AdvancerTechnologies/MuscleMouse/Pictures/20130727_114115.jpg

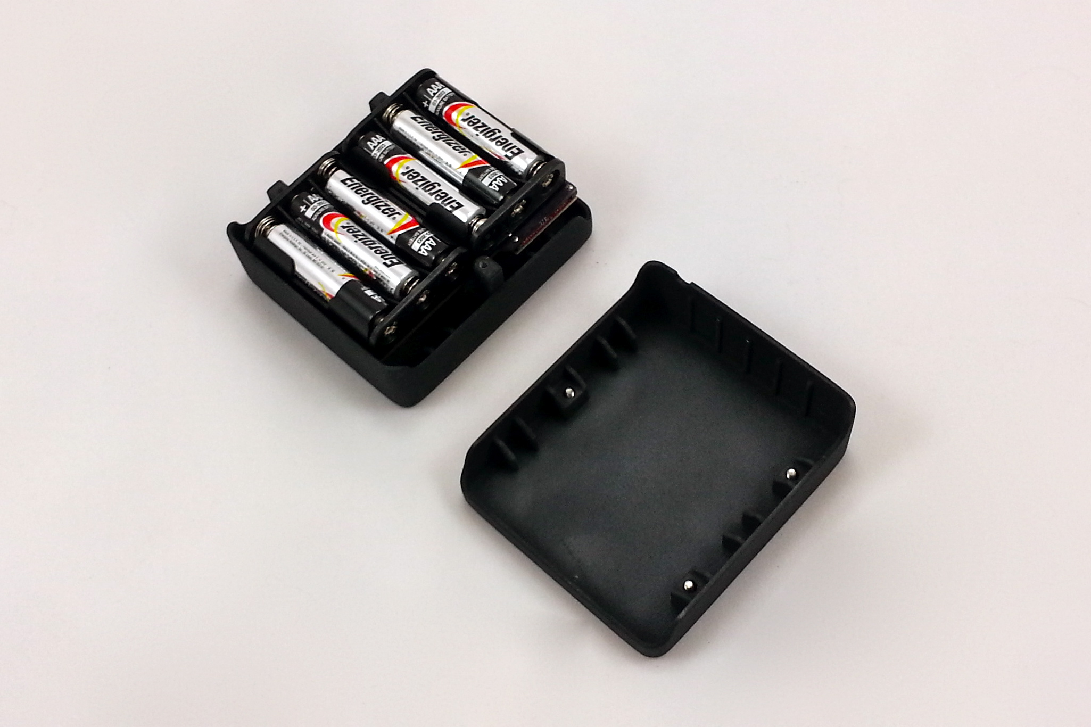
Pictures/20130727_114115.jpg
