AdvancerTechnologies/MuscleMouse/Pictures/20130727_113548.jpg

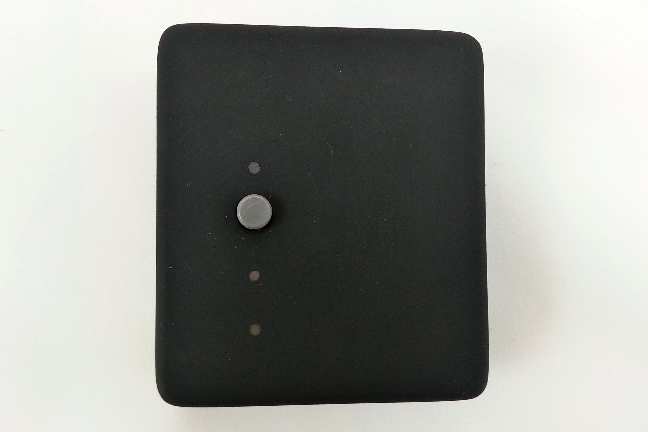
Pictures/20130727_113548.jpg
