AdvancerTechnologies/MuscleMouse/README.md

Muscle-Mouse
============

Example code and files for the Muscle Mouse project
