AdvancerTechnologies/MuscleMouse/Pictures/20130727_113004.jpg

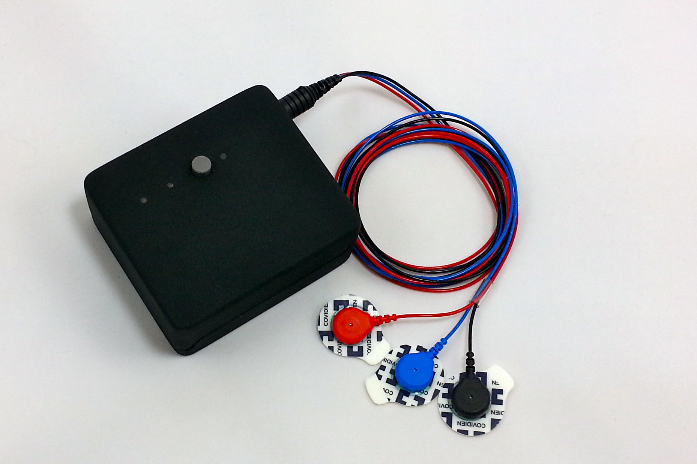
Pictures/20130727_113004.jpg
