AdvancerTechnologies/MuscleMouse/Pictures/20130727_113408.jpg

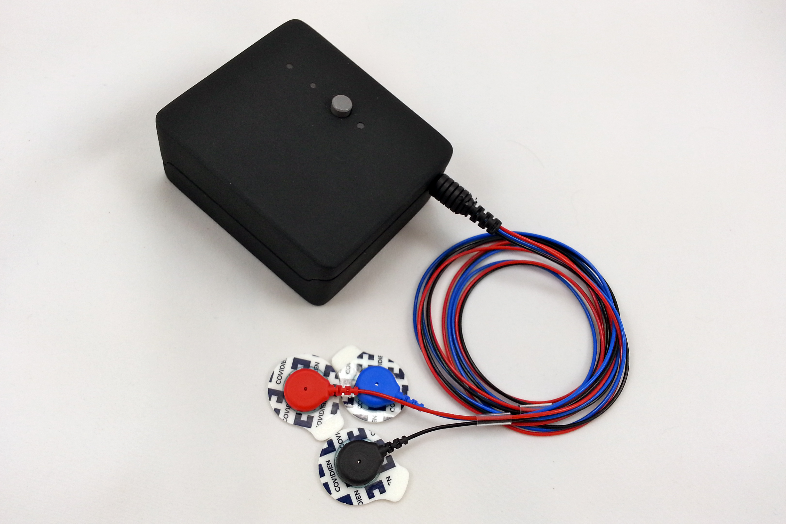
Pictures/20130727_113408.jpg
