AdvancerTechnologies/MuscleMouse/Pictures/20130727_113649.jpg

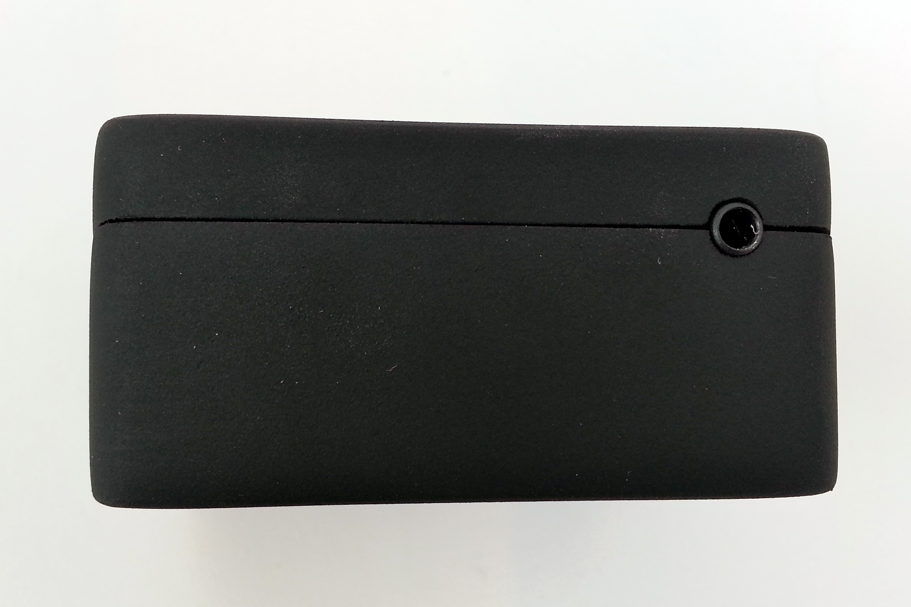
Pictures/20130727_113649.jpg
