AdvancerTechnologies/MuscleMouse/Pictures/20130727_113705.jpg

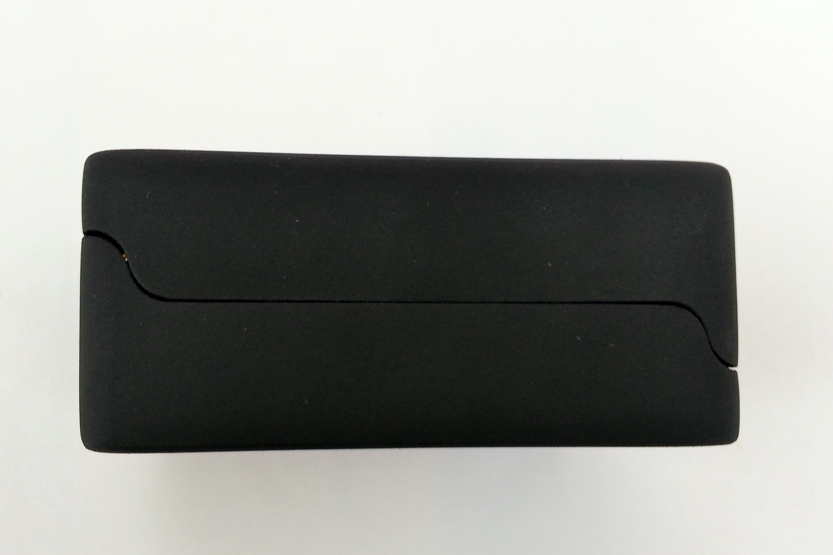
Pictures/20130727_113705.jpg
