AdvancerTechnologies/MuscleMouse/Pictures/20130727_114227.jpg

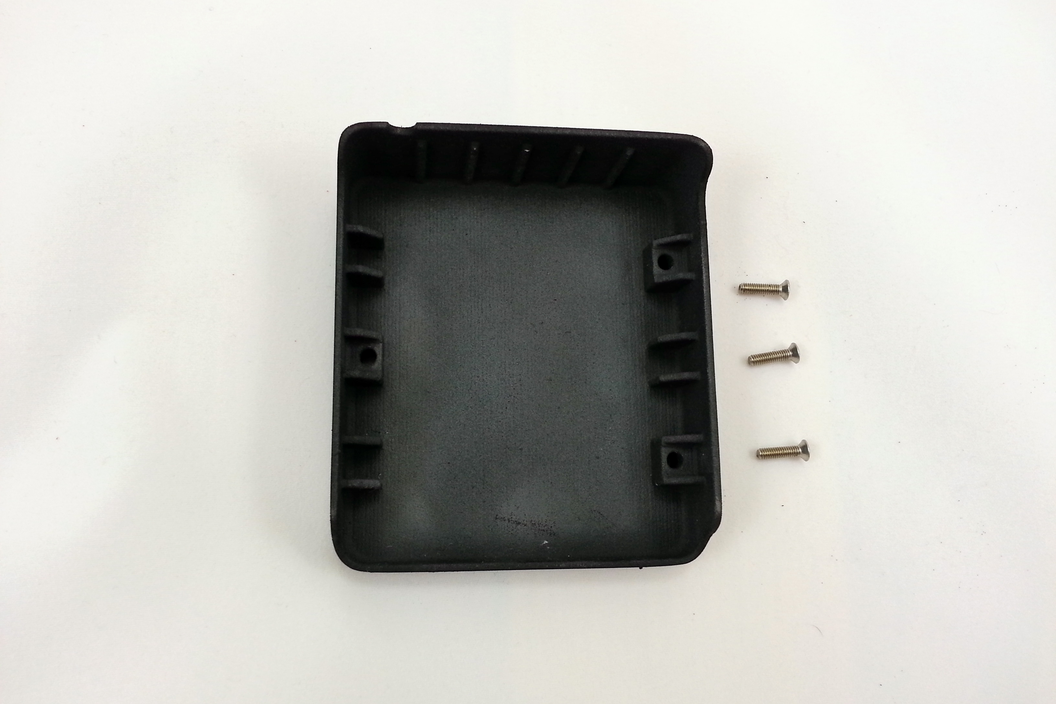
Pictures/20130727_114227.jpg
