AdvancerTechnologies/MuscleMouse/Pictures/20130727_114305.jpg

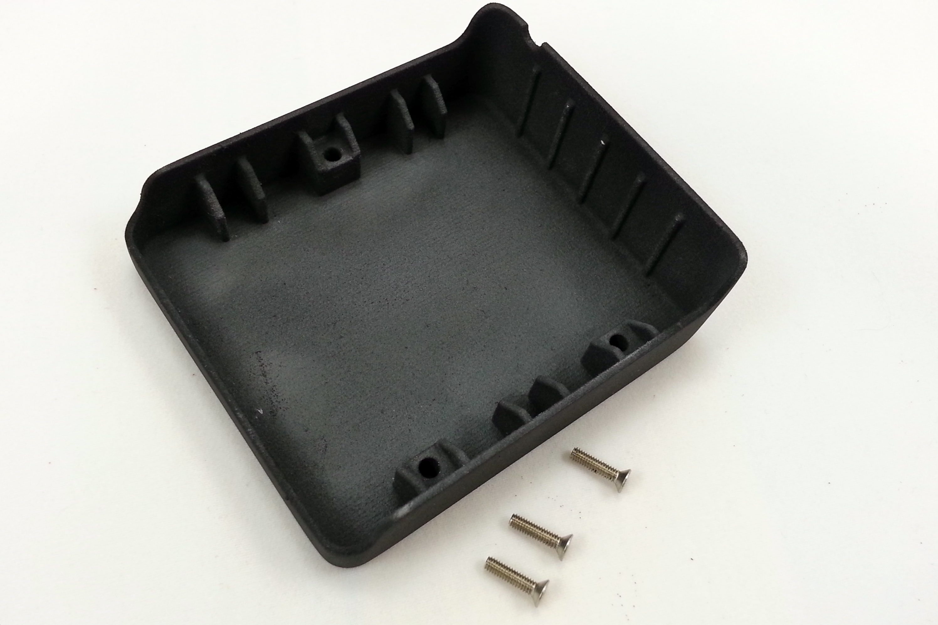
Pictures/20130727_114305.jpg
