AdvancerTechnologies/MuscleMouse/Pictures/20130727_114322.jpg

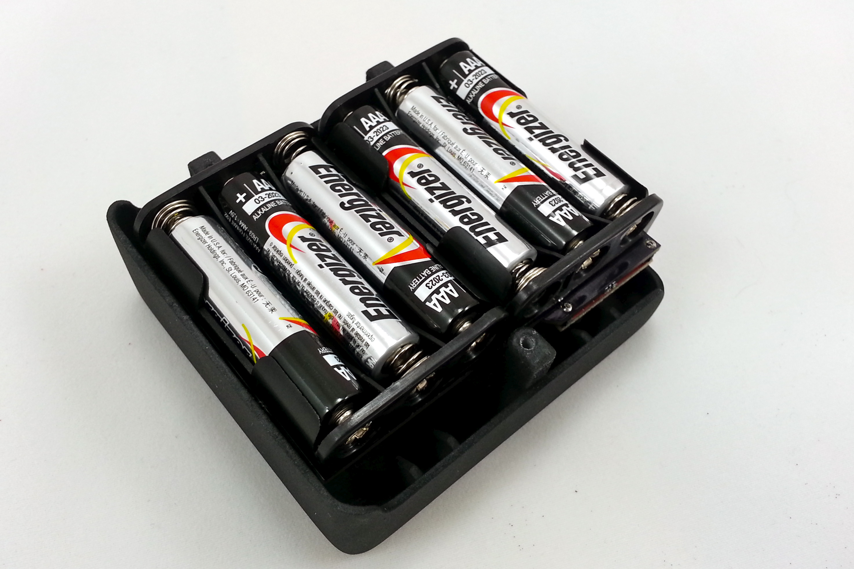
Pictures/20130727_114322.jpg
