AdvancerTechnologies/MuscleMouse/Pictures/20130727_114401.jpg

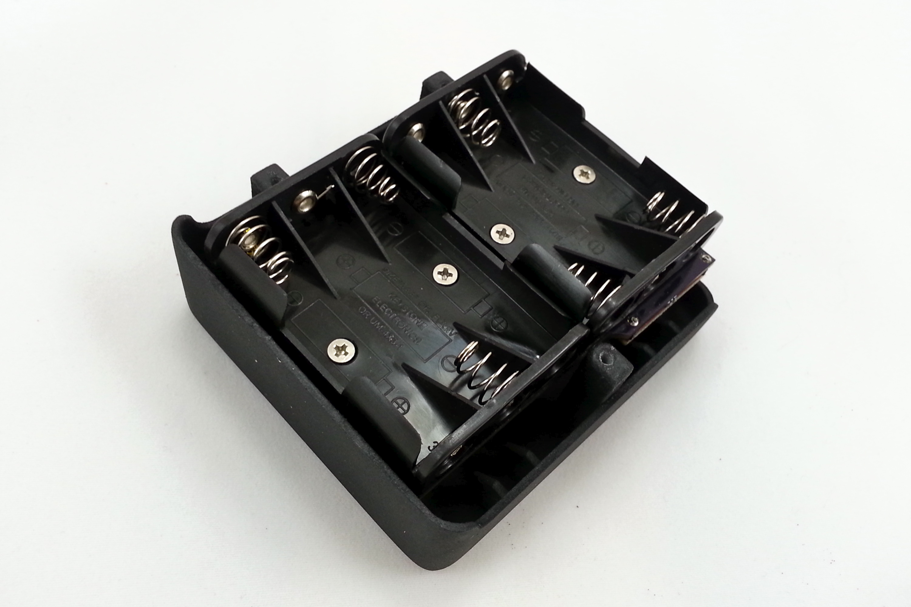
Pictures/20130727_114401.jpg
