AdvancerTechnologies/MuscleMouse/Pictures/20130727_114428.jpg

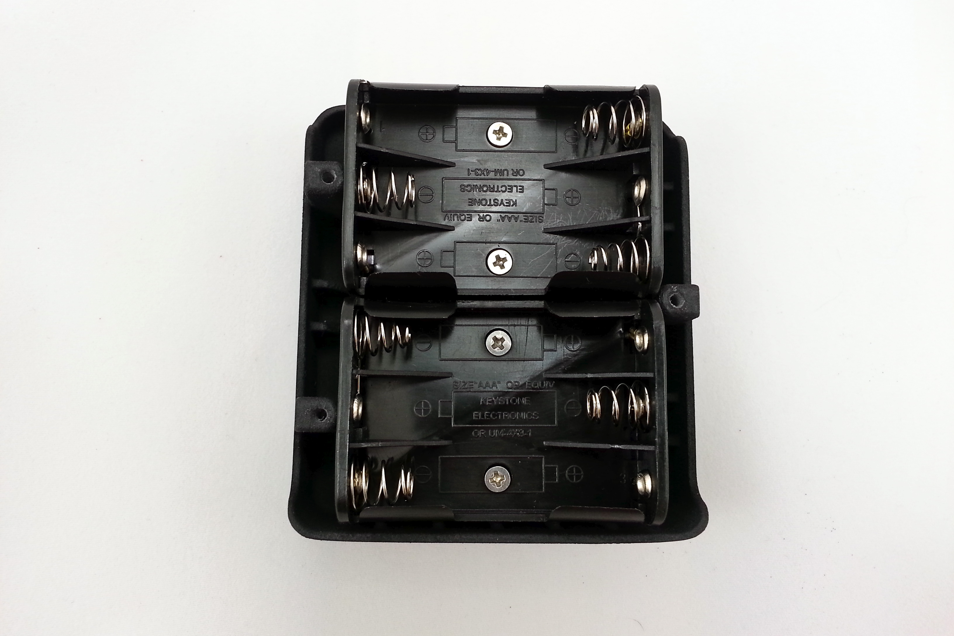
Pictures/20130727_114428.jpg
