AdvancerTechnologies/MuscleMouse/Pictures/20130727_114931.jpg

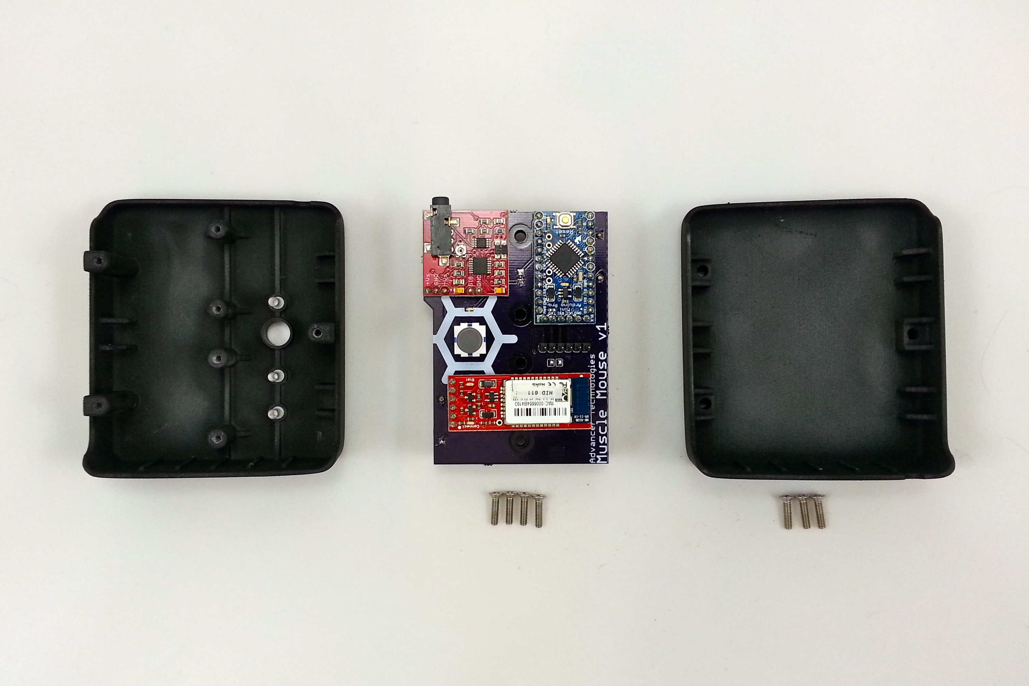
Pictures/20130727_114931.jpg
