AdvancerTechnologies/MuscleMouse/Pictures/20130727_115040.jpg

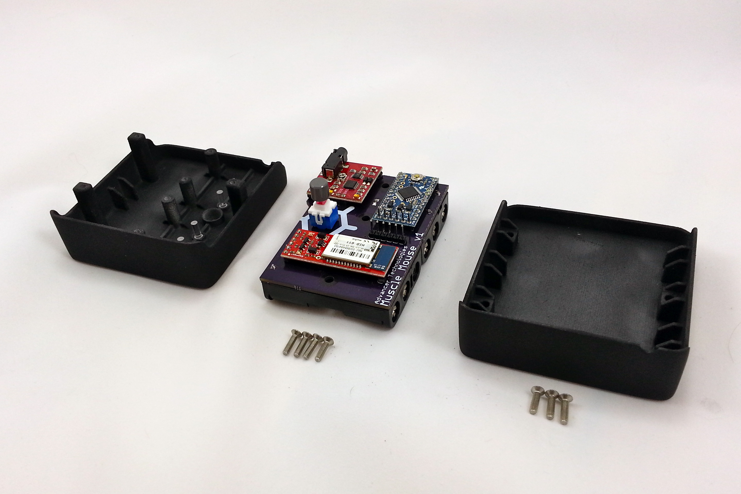
Pictures/20130727_115040.jpg
