AdvancerTechnologies/MuscleMouse/Pictures/20130727_115242.jpg

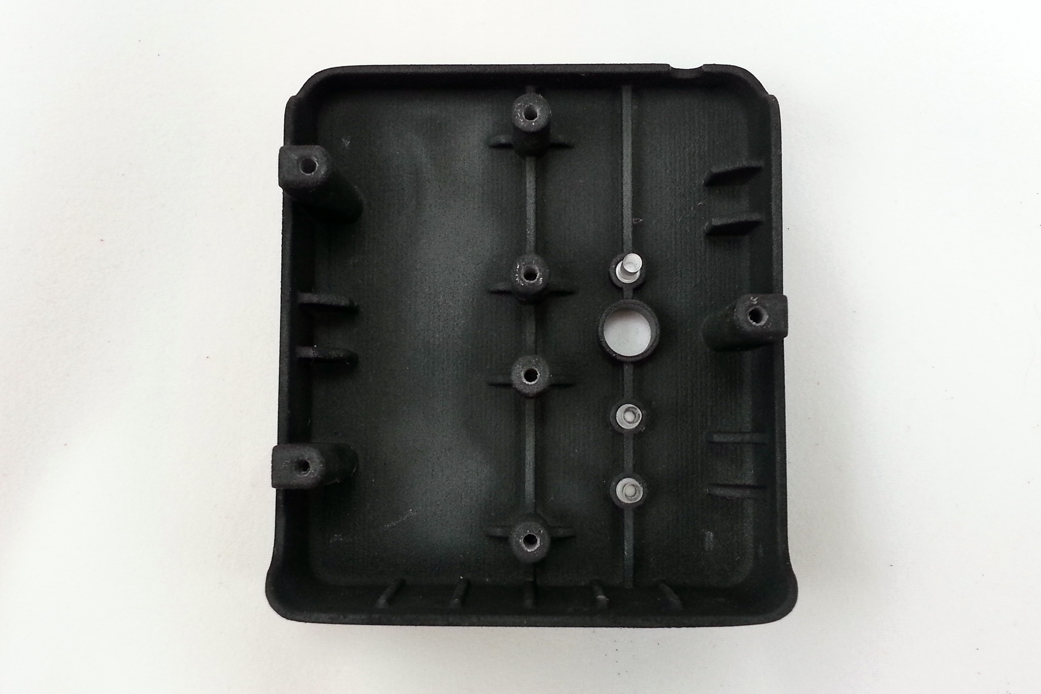
Pictures/20130727_115242.jpg
