AdvancerTechnologies/MuscleMouse/Pictures/20130727_115309.jpg

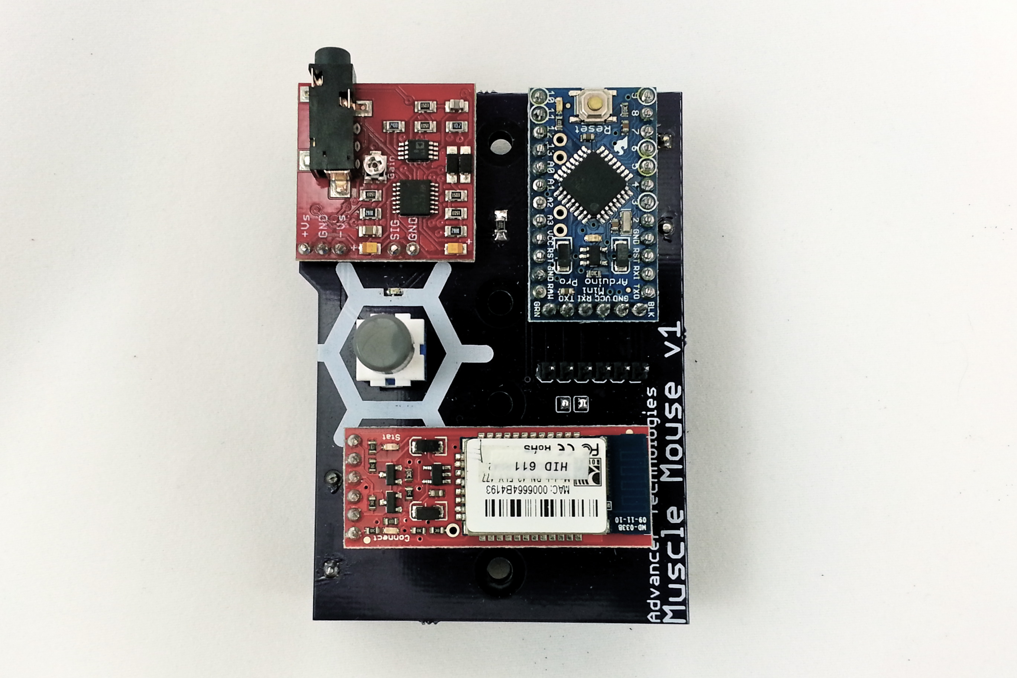
Pictures/20130727_115309.jpg
