AdvancerTechnologies/MuscleMouse/Pictures/20130727_115348.jpg

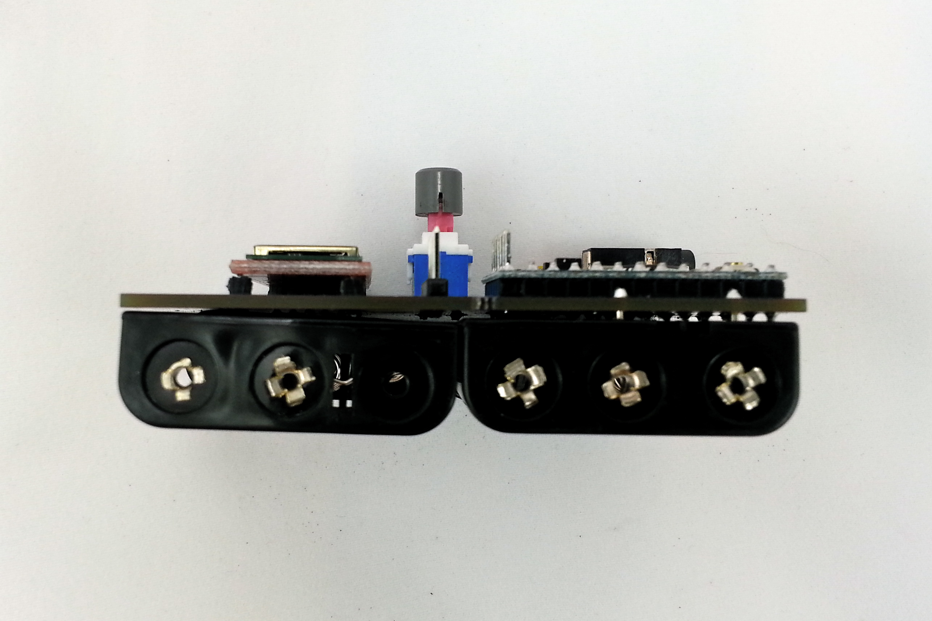
Pictures/20130727_115348.jpg
