AdvancerTechnologies/MuscleMouse/Pictures/20130727_115431.jpg

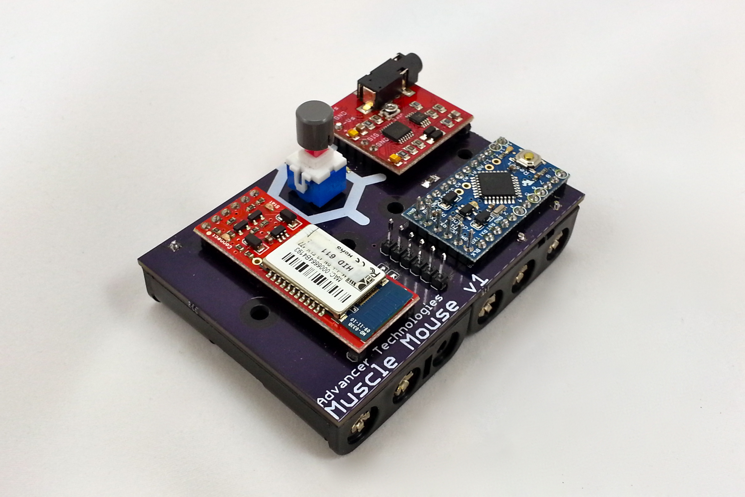
Pictures/20130727_115431.jpg
