AdvancerTechnologies/MuscleMouse/Pictures/20130727_115443.jpg

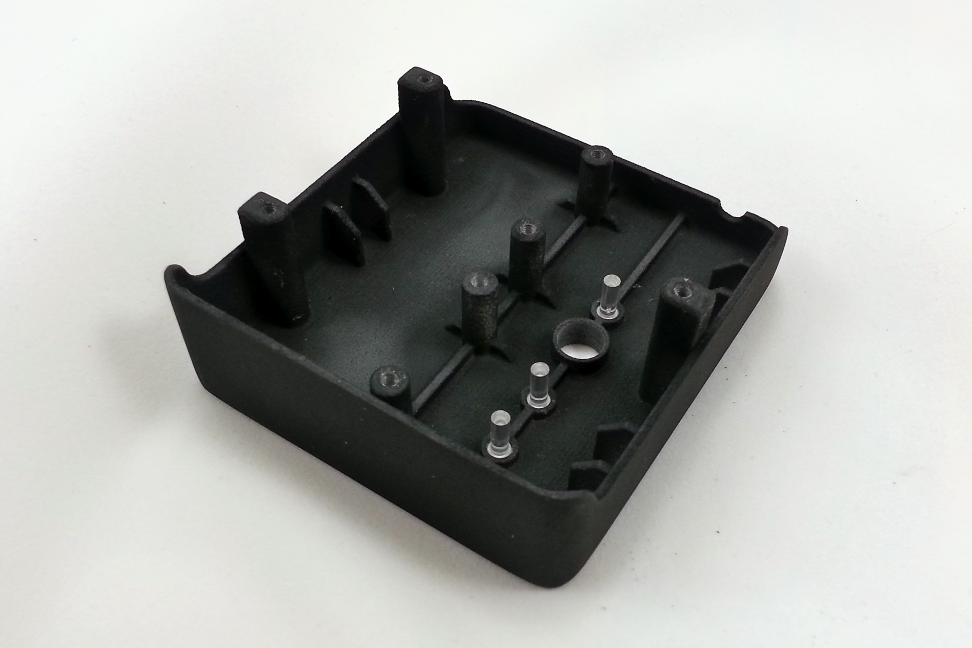
Pictures/20130727_115443.jpg
