AdvancerTechnologies/MuscleMouse/Pictures/20130727_115458.jpg

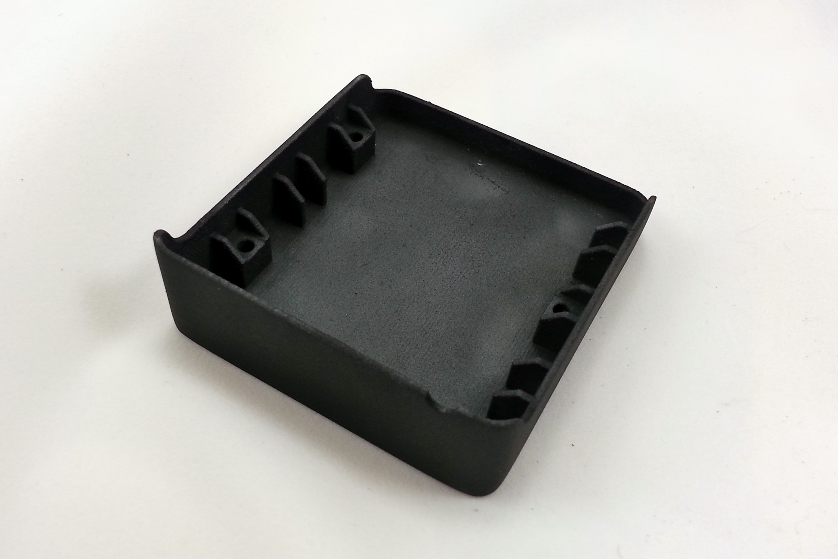
Pictures/20130727_115458.jpg
