AdvancerTechnologies/MuscleMouse/Pictures/20130727_184438_70142.jpg

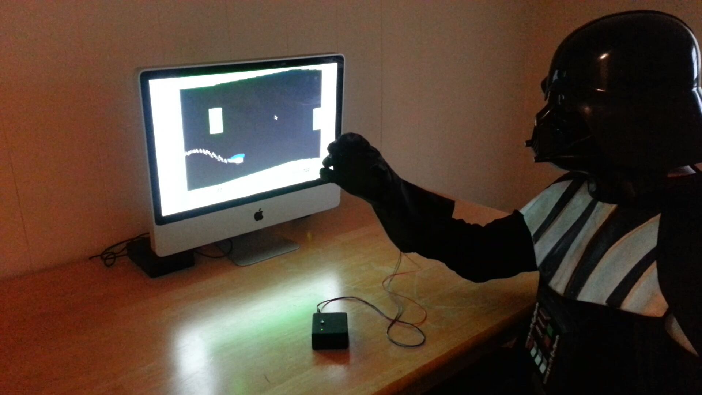
Pictures/20130727_184438_70142.jpg
