AdvancerTechnologies/MuscleMouse/Pictures/20130728_143617_17169.jpg

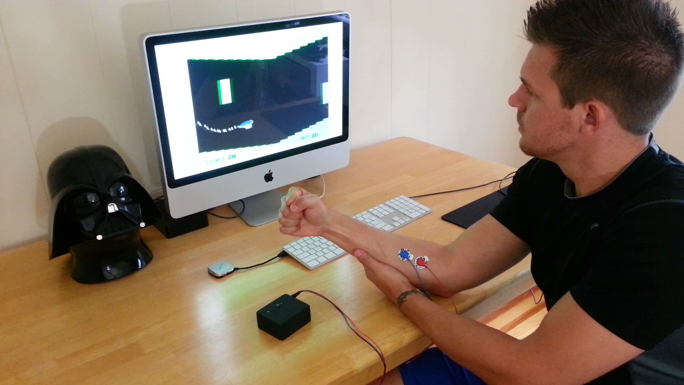
Pictures/20130728_143617_17169.jpg
