AdvancerTechnologies/MuscleMouse/Pictures/20130730_215102.jpg

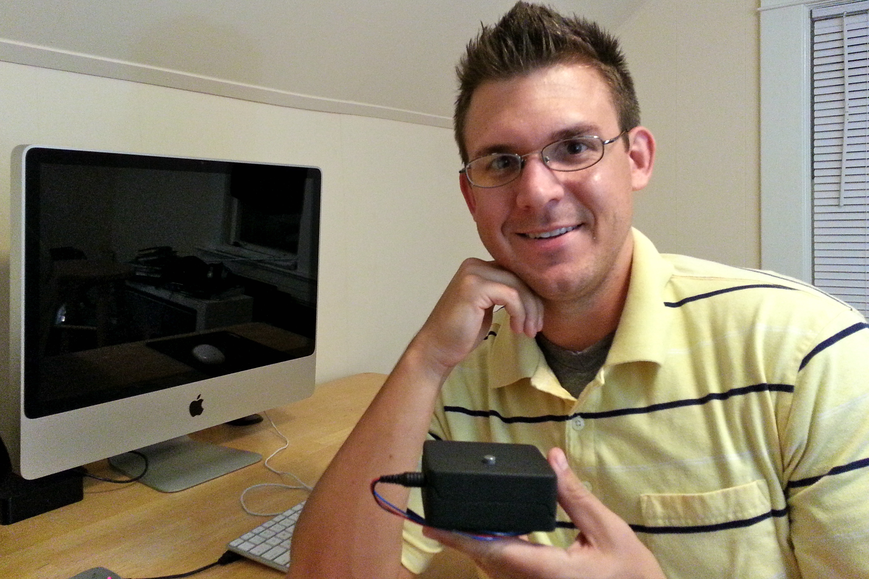
Pictures/20130730_215102.jpg
