AdvancerTechnologies/MuscleMouse/Pictures/Animated Picture 1.gif

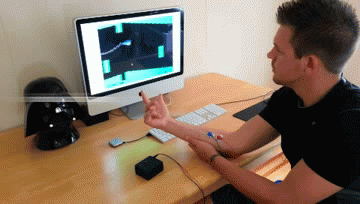
Pictures/Animated Picture 1.gif
