AdvancerTechnologies/MuscleMouse/Pictures/Animated Picture 2.gif

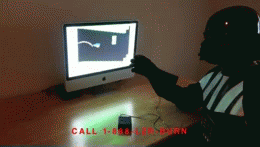
Pictures/Animated Picture 2.gif
