AdvancerTechnologies/MuscleMouse/CAD/Muscle Mouse v1_1.SLDASM

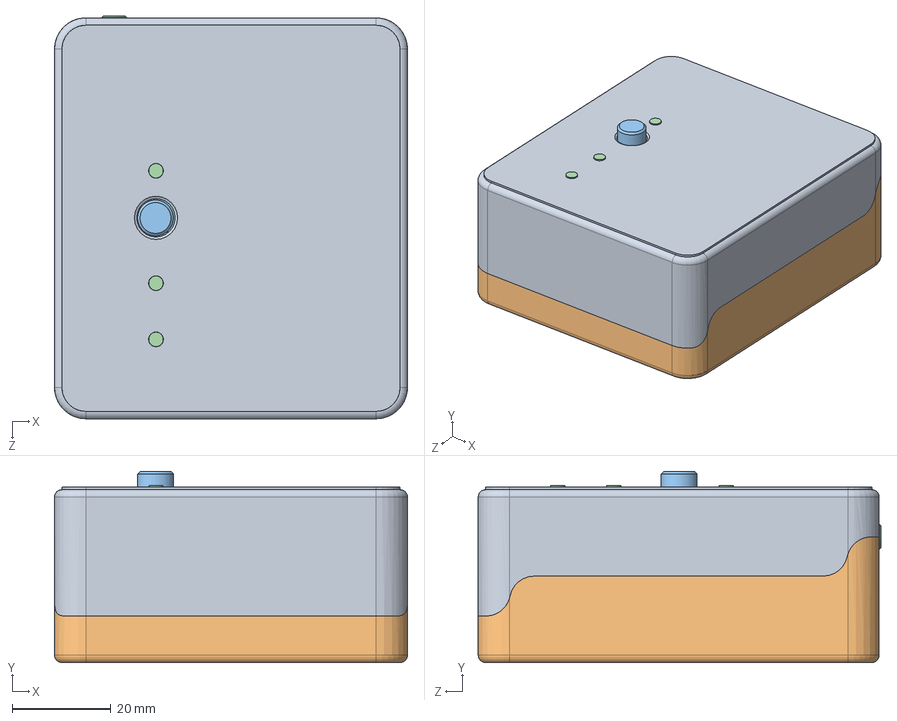
[picture p37: CAD file, 2014-12-28]
CAD/Muscle Mouse v1_1.SLDASM
71.4 x 38.7 x 81.5 mm
EnclosureTop
EnclosureBottom
ButtonCap
11mmLightTube x 3
