AdvancerTechnologies/MuscleMouse/CAD/ClippedPin.SLDPRT

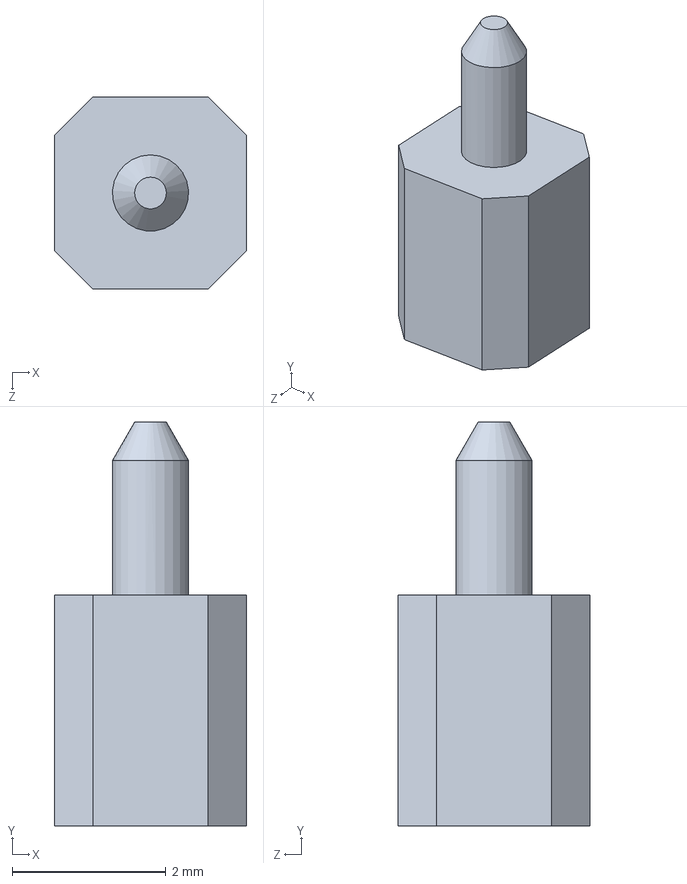
[picture p38: CAD file, 2014-12-28]
CAD/ClippedPin.SLDPRT
2.50 x 5.25 x 2.50 mm
