AdvancerTechnologies/MuscleMouse/CAD/ArduinoMiniPro.SLDPRT

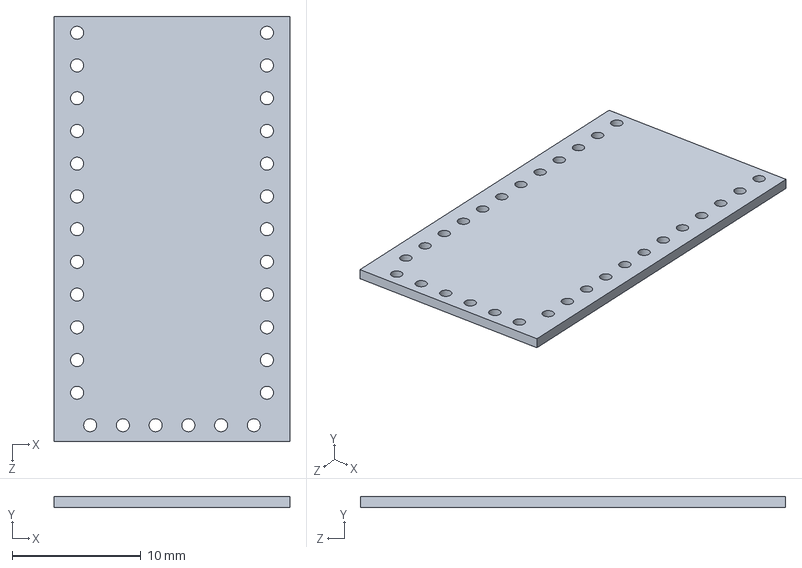
[picture p39: CAD file, 2014-12-28]
CAD/ArduinoMiniPro.SLDPRT
18.3 x 0.85 x 33.0 mm
