AdvancerTechnologies/MuscleMouse/CAD/EnclosureBottom.SLDPRT

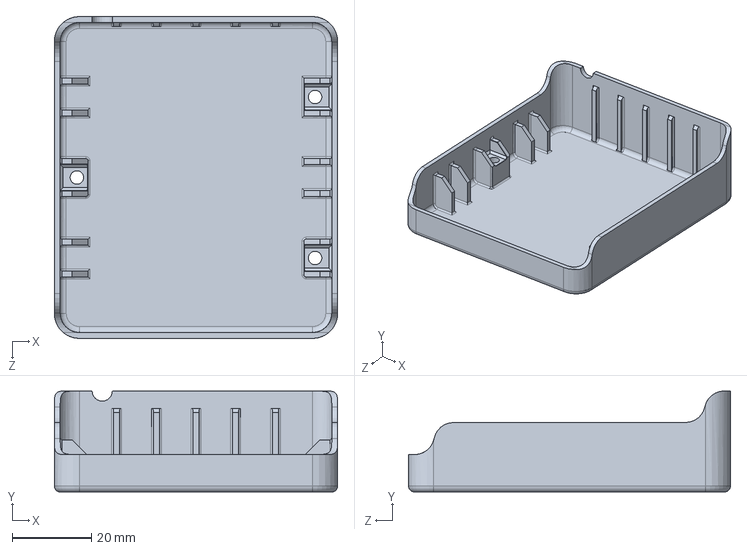
[picture p40: CAD file, 2014-12-28]
CAD/EnclosureBottom.SLDPRT
71.4 x 25.4 x 81.2 mm
