AdvancerTechnologies/MuscleMouse/CAD/keystone-PN2479.SLDPRT

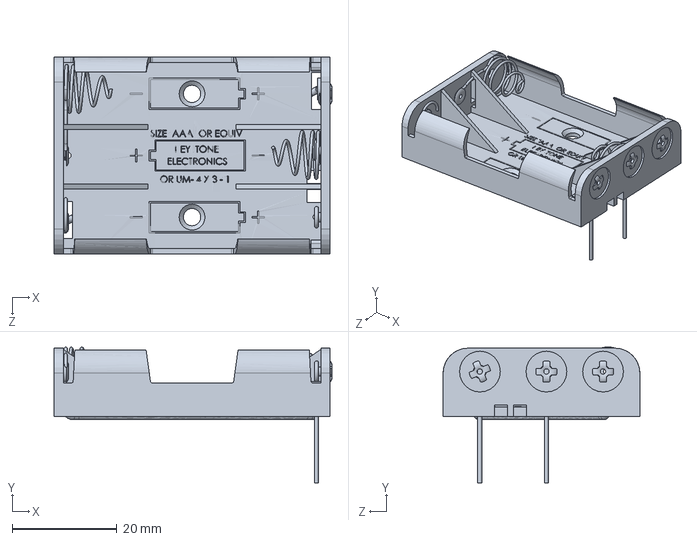
[picture p41: CAD file, 2014-12-28]
CAD/keystone-PN2479.SLDPRT
53.0 x 25.9 x 37.5 mm
