AdvancerTechnologies/MuscleMouse/CAD/HeaderPin.SLDPRT

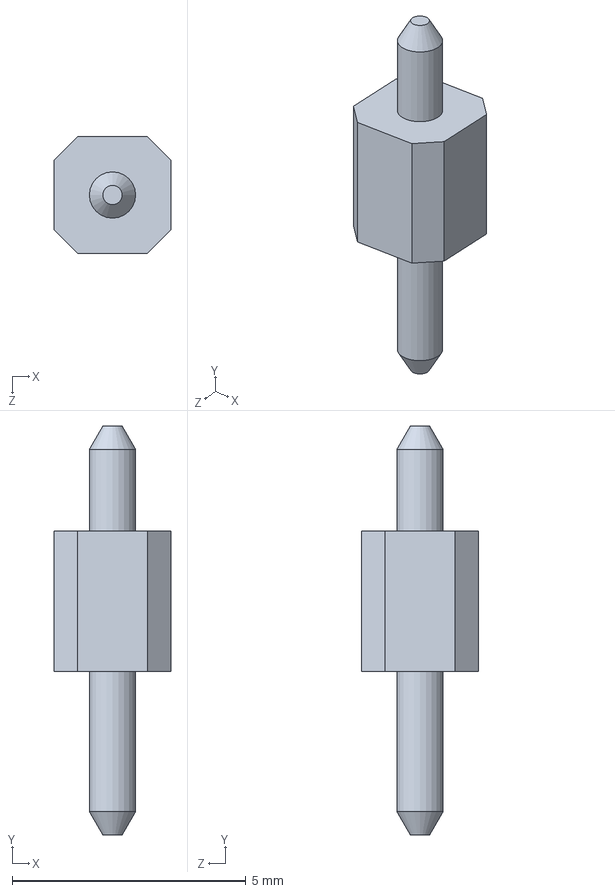
[picture p42: CAD file, 2014-12-28]
CAD/HeaderPin.SLDPRT
2.50 x 8.75 x 2.50 mm
