AdvancerTechnologies/MuscleMouse/CAD/EnclosureTop.SLDPRT

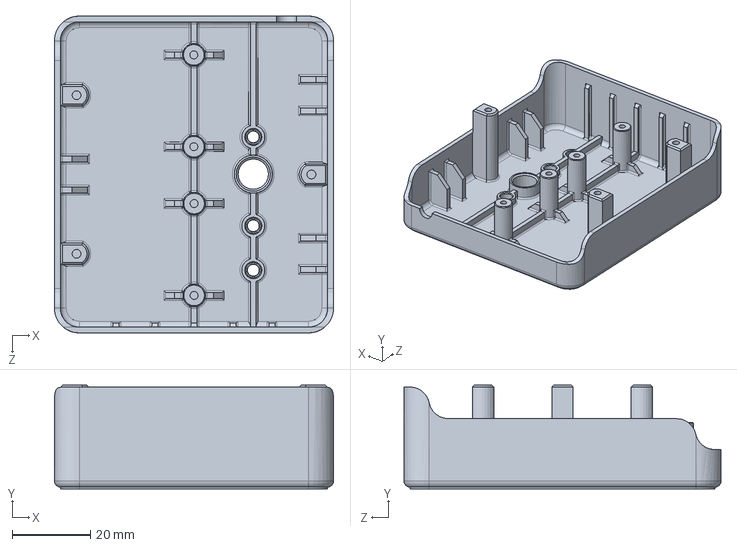
[picture p43: CAD file, 2014-12-28]
CAD/EnclosureTop.SLDPRT
71.4 x 26.6 x 81.2 mm
