AdvancerTechnologies/MuscleMouse/CAD/BluSmiRF HID.SLDPRT

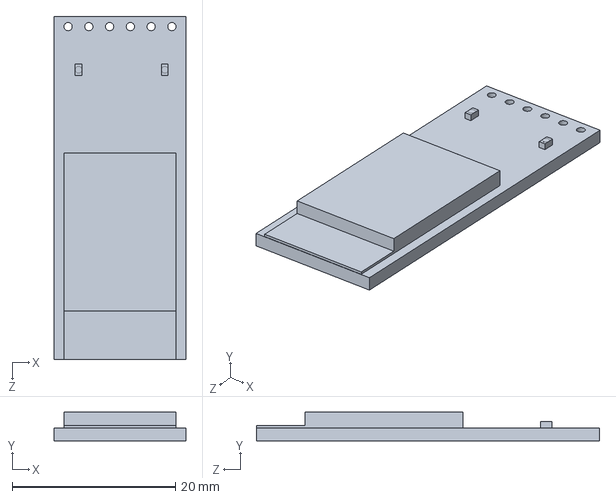
[picture p44: CAD file, 2014-12-28]
CAD/BluSmiRF HID.SLDPRT
16.2 x 3.53 x 42.0 mm
