AdvancerTechnologies/MuscleMouse/CAD/Muscle Sensor v3.SLDPRT

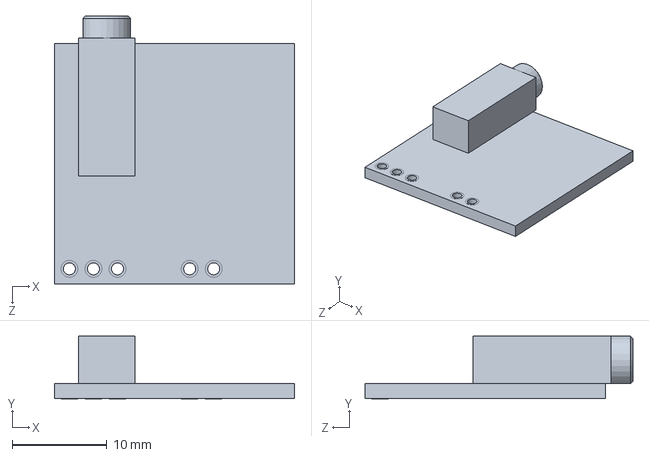
[picture p45: CAD file, 2014-12-28]
CAD/Muscle Sensor v3.SLDPRT
25.4 x 6.61 x 28.3 mm
