AdvancerTechnologies/MuscleMouse/CAD/11mmLightTube.SLDPRT

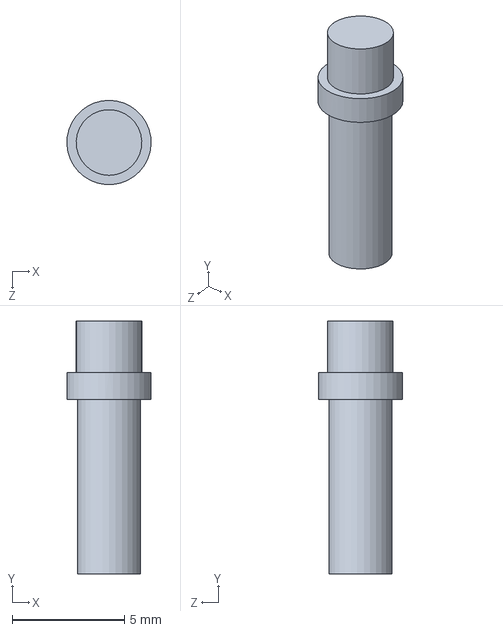
[picture p46: CAD file, 2014-12-28]
CAD/11mmLightTube.SLDPRT
3.75 x 11.2 x 3.75 mm
