AdvancerTechnologies/MuscleMouse/CAD/ButtonCap.SLDPRT

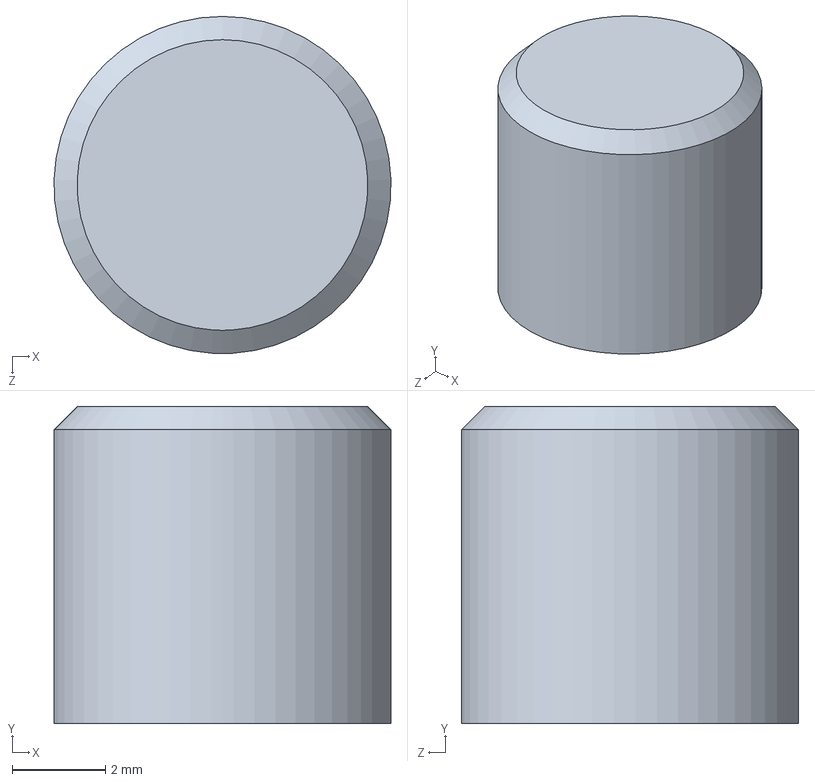
[picture p47: CAD file, 2014-12-28]
CAD/ButtonCap.SLDPRT
7.25 x 6.82 x 7.25 mm
