AdvancerTechnologies/MuscleMouse/CAD/PushbuttonBottom.SLDPRT

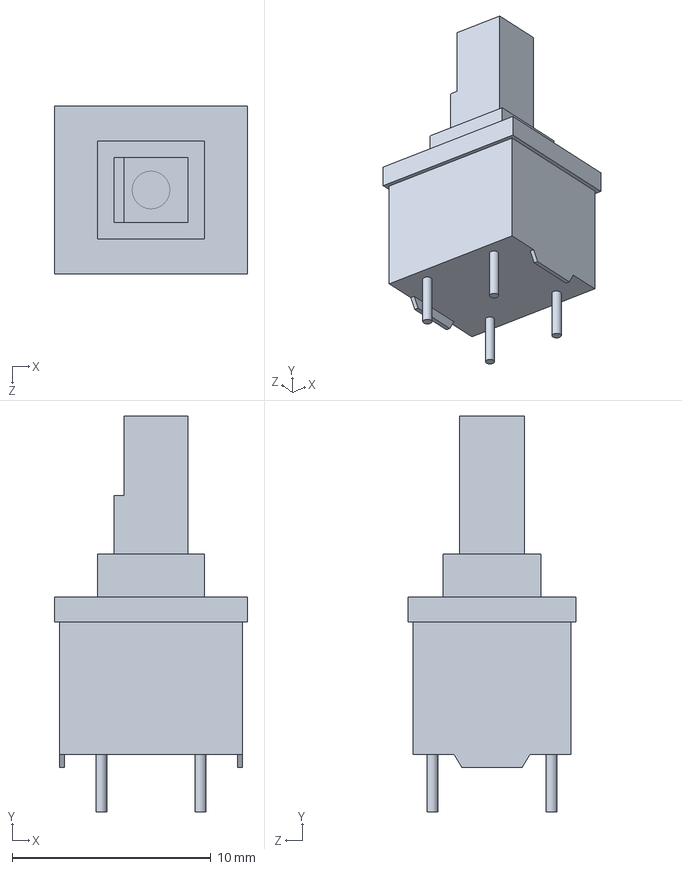
[picture p48: CAD file, 2014-12-28]
CAD/PushbuttonBottom.SLDPRT
9.72 x 19.9 x 8.45 mm
