AdvancerTechnologies/MuscleMouse/CAD/Muscle Mouse Board v1.1.SLDPRT

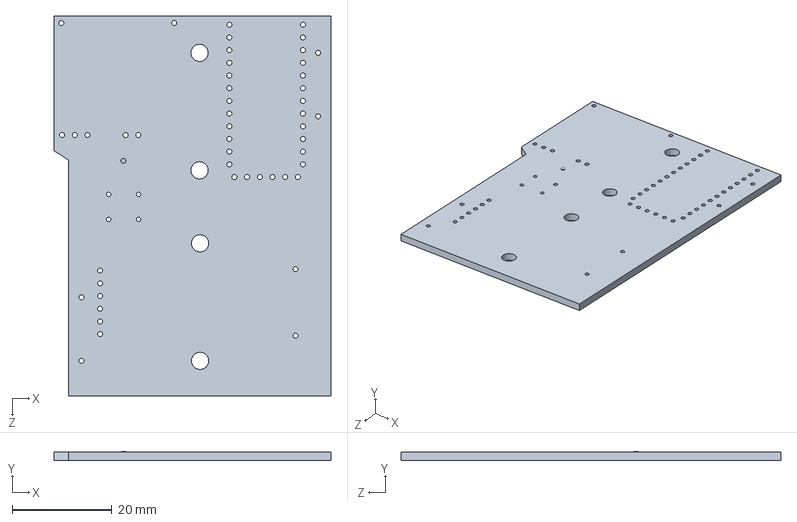
[picture p49: CAD file, 2014-12-28]
CAD/Muscle Mouse Board v1.1.SLDPRT
55.4 x 1.85 x 75.9 mm
