AdvancerTechnologies/MuscleMouse/CAD/91771A106.SLDPRT

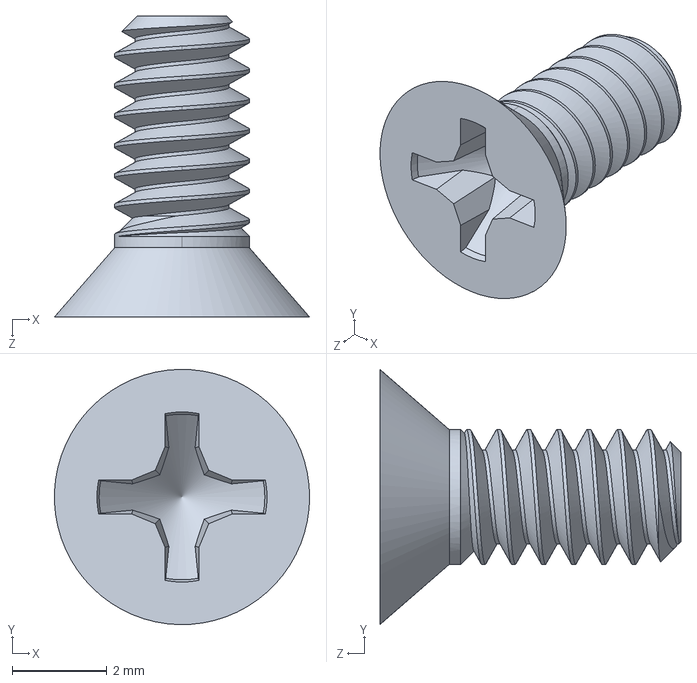
[picture p50: CAD file, 2014-12-28]
CAD/91771A106.SLDPRT
5.38 x 5.38 x 6.35 mm
