AdvancerTechnologies/MuscleMouse/CAD/90241A248.SLDPRT

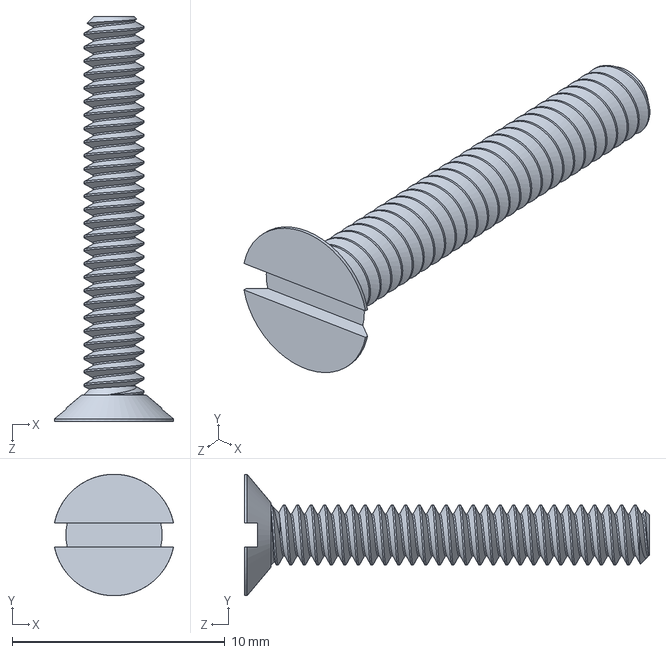
[picture p51: CAD file, 2014-12-28]
CAD/90241A248.SLDPRT
5.61 x 5.72 x 19.0 mm
