AdvancerTechnologies/MuscleMouse/CAD/92010A126.SLDPRT

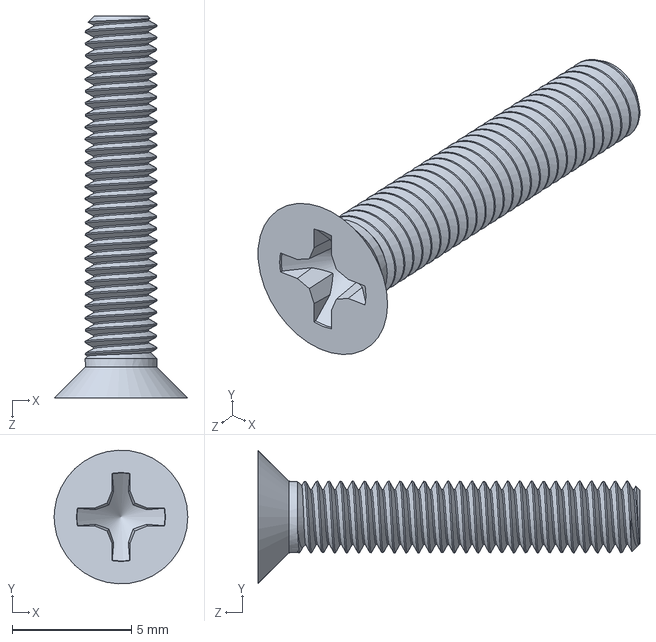
[picture p52: CAD file, 2014-12-28]
CAD/92010A126.SLDPRT
5.60 x 5.59 x 16.0 mm
