AdvancerTechnologies/MuscleMouse/CAD/91771A083.SLDPRT

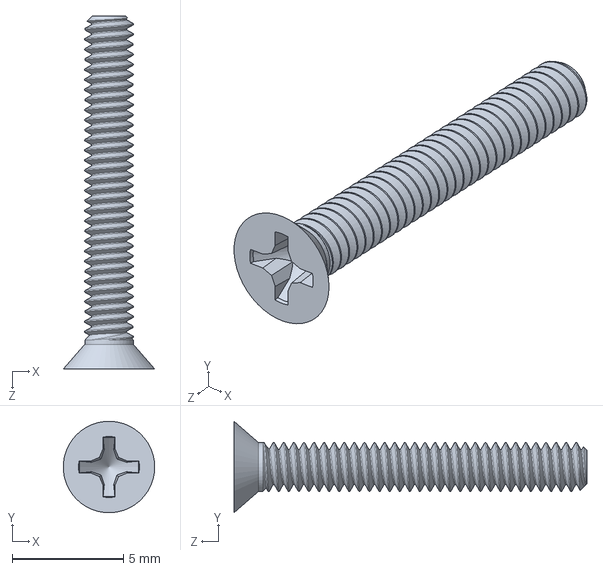
[picture p53: CAD file, 2014-12-28]
CAD/91771A083.SLDPRT
4.11 x 4.11 x 15.9 mm
