AdvancerTechnologies/MuscleMouse/CAD/92010A024.SLDPRT

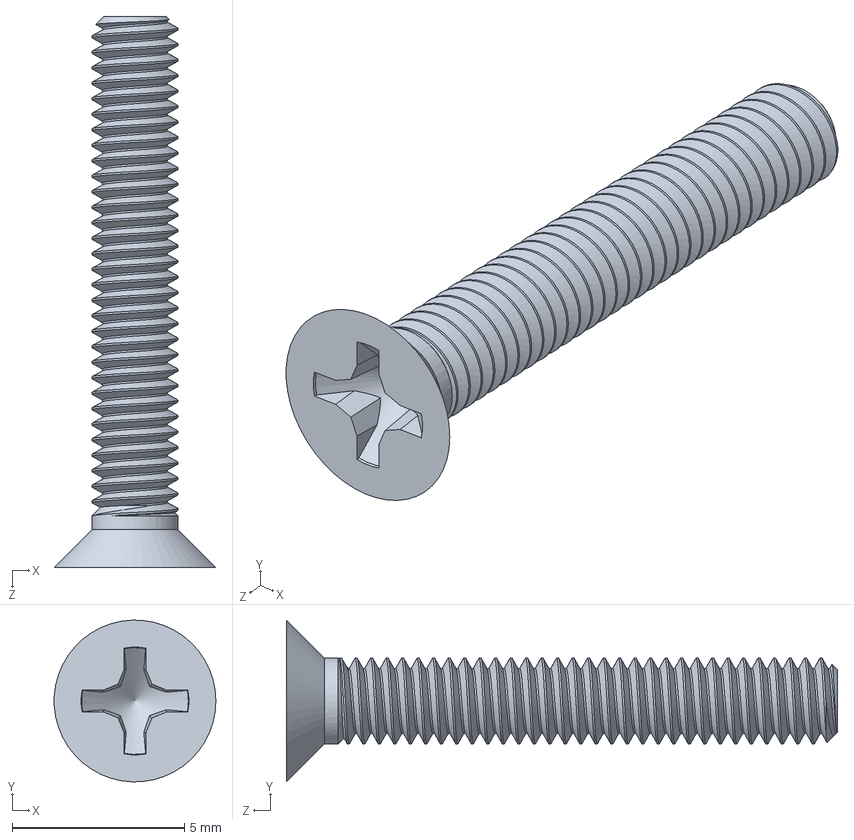
[picture p54: CAD file, 2014-12-28]
CAD/92010A024.SLDPRT
4.70 x 4.70 x 16.0 mm
