AdvancerTechnologies/MuscleMouse/(list of files, cad)

Other CAD files:
CAD/90241A242.SLDPRT
CAD/90471A163.SLDPRT
CAD/91771A110.SLDPRT
CAD/91771A112.SLDPRT
CAD/91771A115.SLDPRT
CAD/92010A018.SLDPRT
CAD/92010A020.SLDPRT
CAD/92010A022.SLDPRT
CAD/94605A112.SLDPRT
CAD/94605A113.SLDPRT
CAD/EnclosureBottom.STL
CAD/EnclosureTop.STL
