AdvancerTechnologies/MuscleMouse/PCB/MuscleMouse.brd

## EAGLE design PCB/MuscleMouse.brd (2014-12-28)

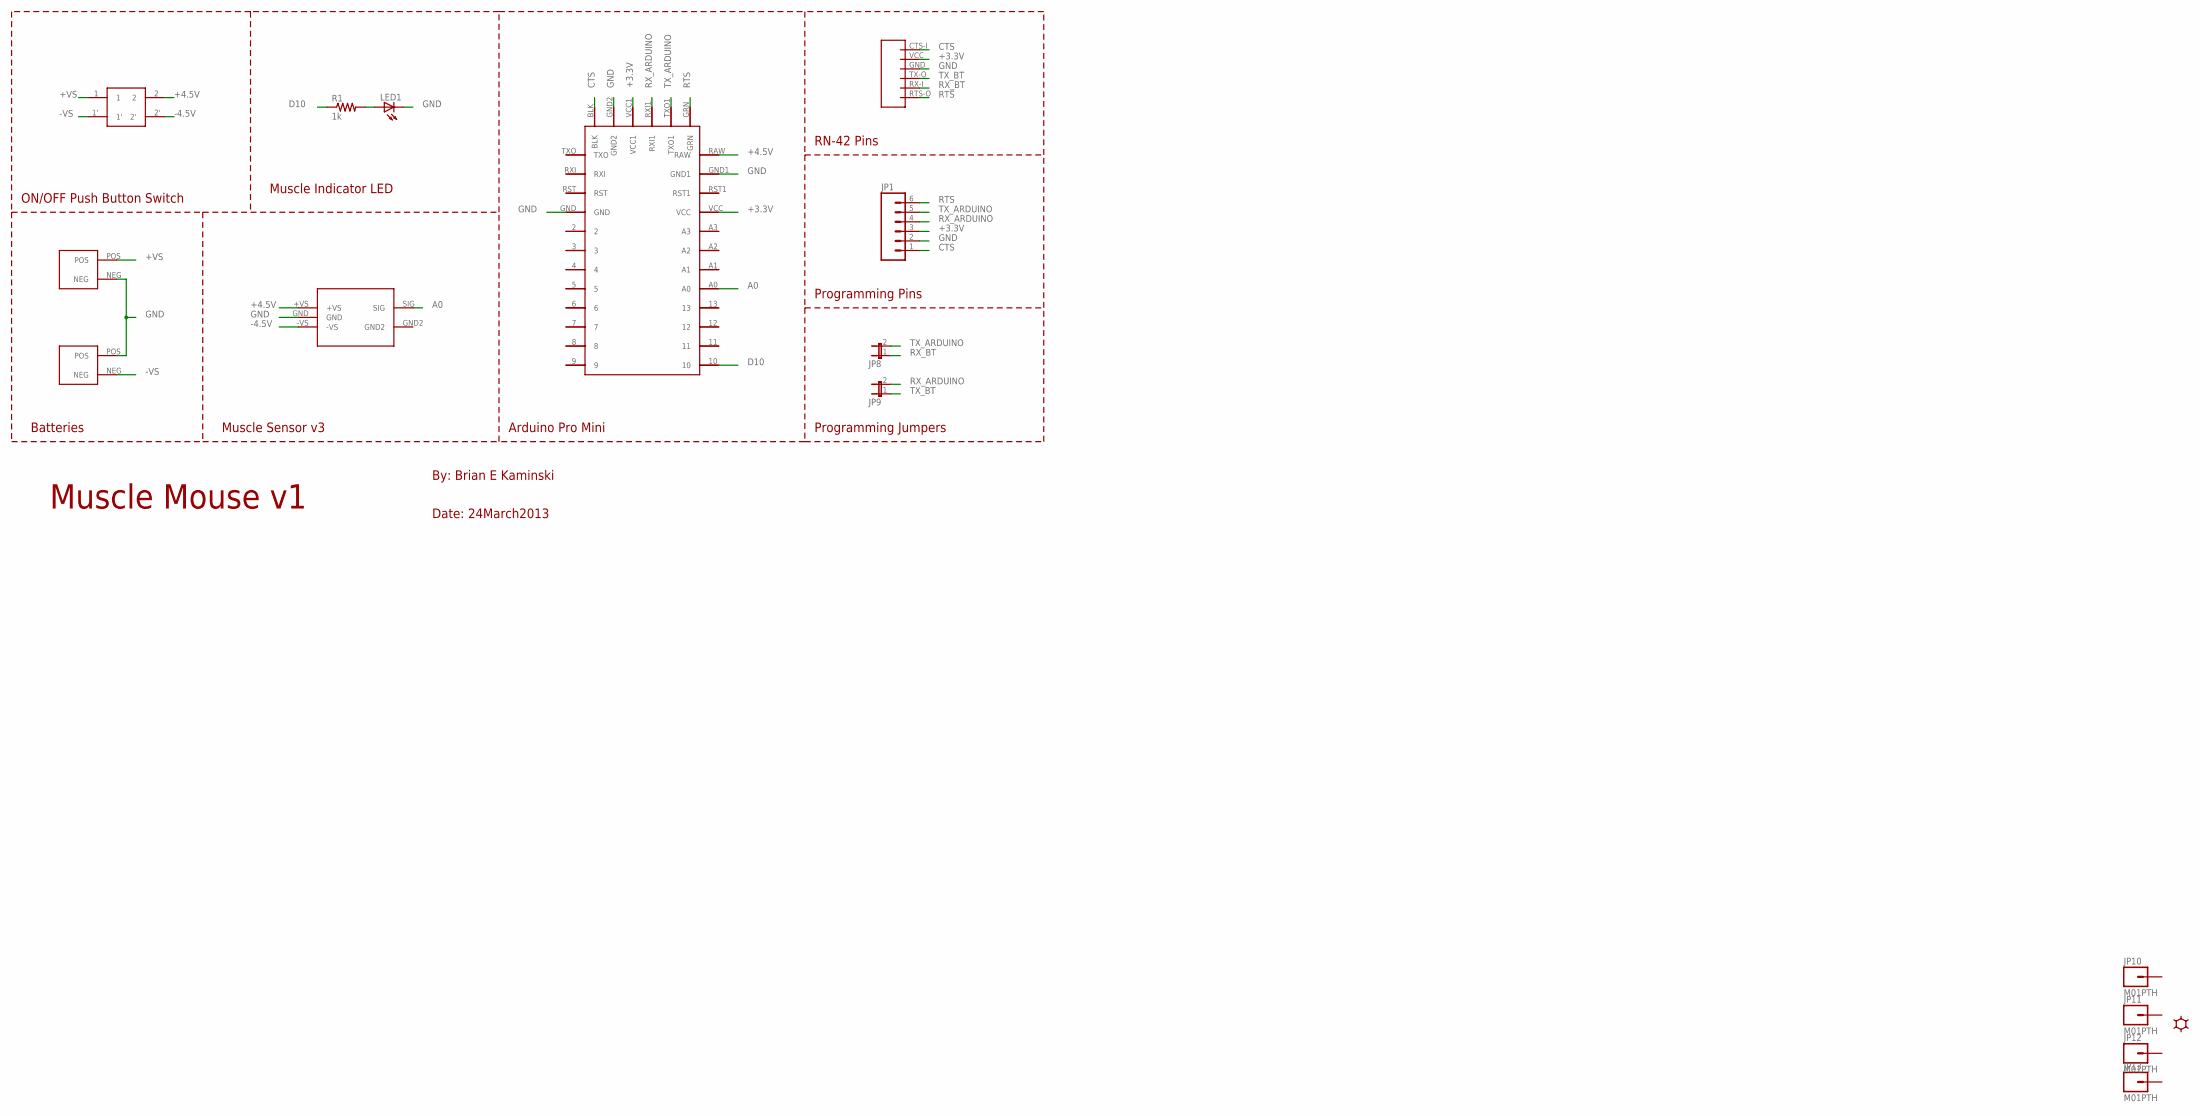
[picture p55: schematic MuscleMouse.sch]

Parts:
JP1: M06SIP; 1X06
JP8, JP9: JUMPER-2SMD-NC; SJ_2S
JP10, JP11, JP12, JP13: M01PTH; 1X01
LED1: LED0603; LED-0603
R1: 1k; 1206
U$1, U$2: AAA_BATT_HOLDER_3STACK
U$3: BLUESMIRF_HID
U$4: MUSCLE_SENSOR_V3
U$5: ARDUINO_PRO_MINI
U$6: ON_OFF_BUTTON
U$7: LOGOBIG; LOGO_BIG

Connections:
+3.3V: JP1.3, U$3.VCC, U$5.VCC, U$5.VCC1
+4.5V: U$4.+VS, U$5.RAW, U$6.2
+VS: U$1.POS, U$6.1
-4.5V: U$4.-VS, U$6.2'
-VS: U$2.NEG, U$6.1'
A0: U$4.SIG, U$5.A0
CTS: JP1.1, U$3.CTS-I, U$5.BLK
D10: R1.1, U$5.10
GND: JP1.2, LED1.C, U$1.NEG, U$2.POS, U$3.GND, U$4.GND, U$5.GND, U$5.GND1, U$5.GND2
unnamed: LED1.A, R1.2
RTS: JP1.6, U$3.RTS-O, U$5.GRN
RX_ARDUINO: JP1.4, JP9.2, U$5.RXI1
RX_BT: JP8.1, U$3.RX-I
TX_ARDUINO: JP1.5, JP8.2, U$5.TXO1
TX_BT: JP9.1, U$3.TX-O

Notes on the sheet:
Arduino Pro Mini
Batteries
Programming Jumpers
Muscle Sensor v3
ON/OFF Push Button Switch
Muscle Indicator LED
Programming Pins
RN-42 Pins
Muscle Mouse v1
By: Brian E Kaminski
Date: 24March2013

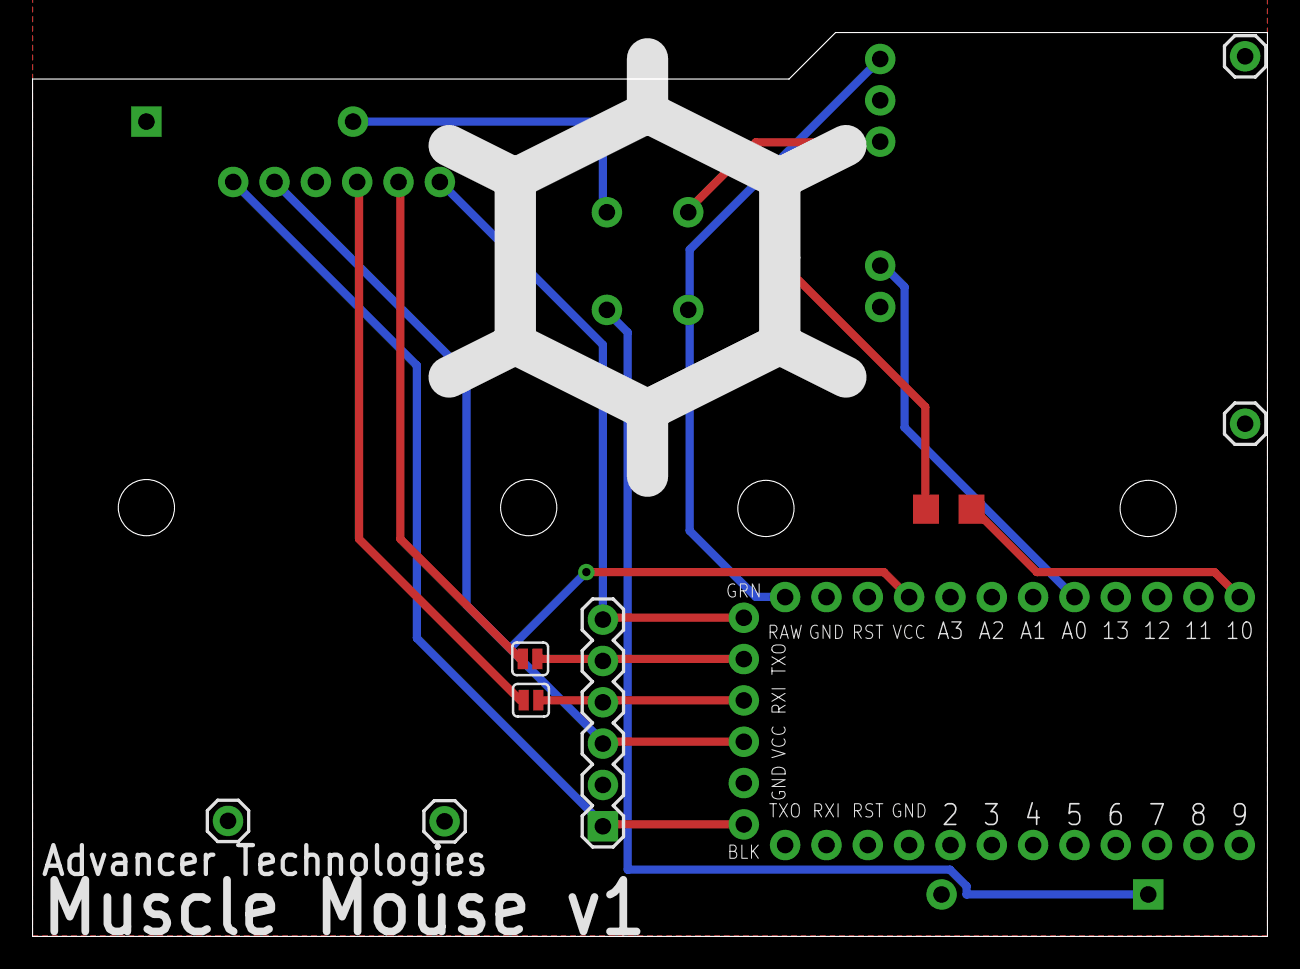
[picture p56: board MuscleMouse.brd from above]

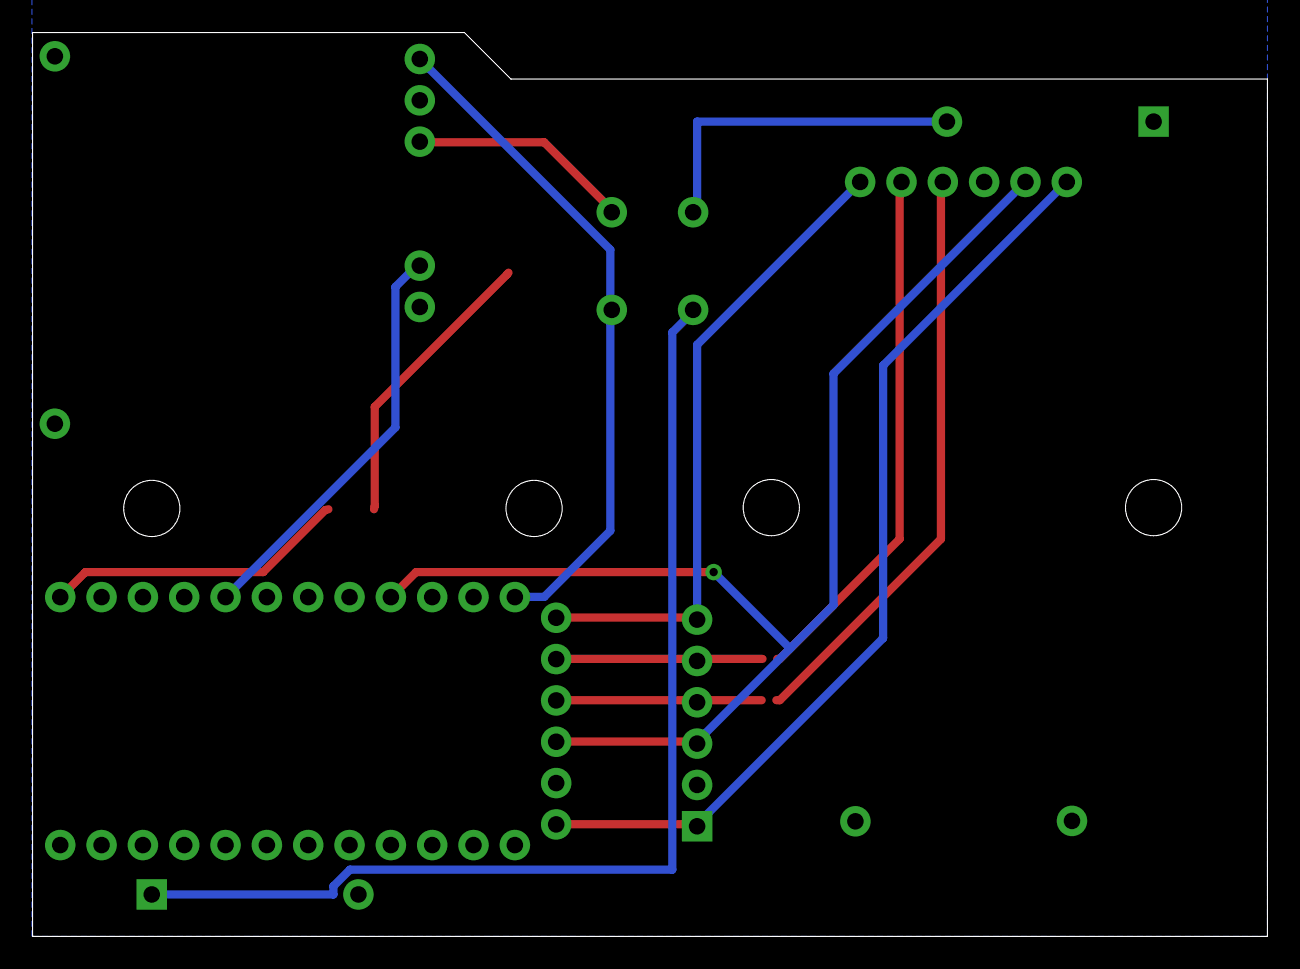
[picture p57: board MuscleMouse.brd from below]

Board: 2 copper layers, 75.9 x 55.5 mm, 16 parts (3 on the bottom side), 15 nets.
